apohlman123/capstone-project/pd_patches/CurrentProblemsWithPD.rtf

Pure Data Problems

High Priority:

1. When sampler’s pitch is altered, sample continues to loop instead of playing one time through
2. Attack doesn’t make linear change with sample playback

Other Problems:

Opening sound files with path in Sampler
Adsr envelope array visualization is not accurate
Clicks on filter type change
Reset plays trigger sample over again

Additional creative tasks (not problems)
• Calculating Q value of filter instead of 0 to 1 value
•
