apohlman123/capstone-project/Schematic_Diagrams/H-API_Sequencer.pdf

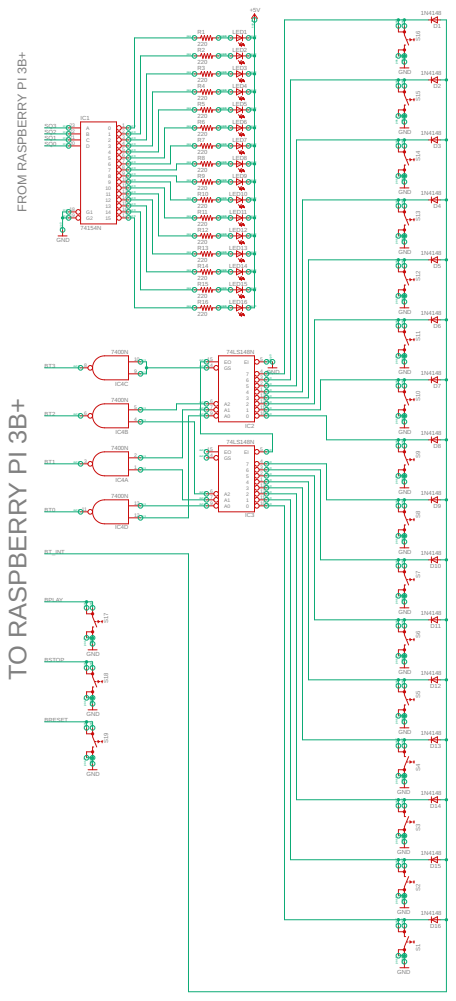
[picture p1: page 1]

FROM RASPBERRY PI 3B+ TO RASPBERRY PI 3B+ +5V GND 220 220 220 220 220 220 220 220 220 220 220 220 220 220 220 220 74154N GND GND GND GND 74LS148N 74LS148N GND 7400N 7400N 7400N 7400N GND GND GND GND GND GND GND GND GND GND GND GND 1N4148 1N4148 1N4148 1N4148 1N4148 1N4148 1N4148 1N4148 1N4148 1N4148 1N4148 1N4148 1N4148 1N4148 1N4148 1N4148 GND GND GND LED1 LED2 LED3 LED4 LED5 LED6 LED7 LED8 LED9 LED10 LED11 LED12 LED13 LED14 LED15 LED16 R1 R2 R3 R4 R5 R6 R7 R8 R9 R10 R11 R12 R13 R14 R15 R16 IC1 0 1 1 2 2 3 3 4 4 5 5 6 6 7 7 8 8 9 9 10 10 11 11 13 12 14 13 15 14 16 15 17 G1 18 G2 19 D 20 C 21 B 22 A 23 S2 S3 S4 S1 S5 S6 S7 S8 S9 S10 S11 S12 S13 S14 S15 S16 IC2 4 1 5 2 6 3 7 4 EI 5 A2 6 A1 7 A0 9 0 10 1 11 2 12 3 13 GS 14 EO 15 IC3 4 1 5 2 6 3 7 4 EI 5 A2 6 A1 7 A0 9 0 10 1 11 2 12 3 13 GS 14 EO 15 IC4A 12 3 IC4B 45 6 IC4C 910 8 IC4D 1213 11 D1 D2 D3 D4 D5 D6 D7 D8 D9 D10 D11 D12 D13 D14 D15 D16 S17 S18 S19 SQ3 SQ2 SQ1 SQ0 BT3 BT2 BT1 BT0 BT_INT BSTOP BPLAY BRESET pas 0 pas 0 pas 0 pas 0 pas 0 pas 0 pas 0 pas 0 pas 0 pas 0 pas 0 pas 0 pas 0 pas 0 pas 0 pas 0 pas 0 pas 0 pas 0 pas 0 pas 0 pas 0 pas 0 pas 0 pas 0 pas 0 pas 0 pas 0 pas 0 pas 0 pas 0 pas 0sup 0 sup 0 pas 1 pas 1 pas 1 pas 1 pas 1 pas 1 pas 1 pas 1 pas 1 pas 1 pas 1 pas 1 pas 1 pas 1 pas 1 pas 1 pas 1 pas 1 pas 1 pas 1 pas 1 pas 1 pas 1 pas 1 pas 1 pas 1 pas 1 pas 1 pas 1 pas 1 pas 1 pas 1 out 0 out 0 out 0 out 0 out 0 out 0 out 0 out 0 out 0 out 0 out 0 out 0 out 0 out 0 out 0 out 0 in 0 in 0 in 0 in 0 in 0 in 0 pas 1 pas 1 pas 2 pas 2 pas 1 pas 1 pas 2 pas 2 pas 1 pas 1 pas 2 pas 2 sup 0 sup 0 pas 1 pas 1 pas 2 pas 2 pas 1 pas 1 pas 2 pas 2 pas 1 pas 1 pas 2 pas 2 pas 1 pas 1 pas 2 pas 2 pas 1 pas 1 pas 2 pas 2 pas 1 pas 1 pas 2 pas 2 pas 1 pas 1 pas 2 pas 2 pas 1 pas 1 pas 2 pas 2 pas 1 pas 1 pas 2 pas 2 pas 1 pas 1 pas 2 pas 2 pas 1 pas 1 pas 2 pas 2 pas 1 pas 1 pas 2 pas 2 pas 1 pas 1 pas 2 pas 2 sup 0 sup 0 in 0 in 0 in 0 in 0 in 0 out 0 out 0 out 0 in 0 in 0 in 0 in 0 out 0 out 0 in 0 in 0 in 0 in 0 in 0 out 0 out 0 out 0 in 0 in 0 in 0 in 0 out 0 out 0 sup 0 in 1 in 1 out 0 in 1 in 1 out 0 in 1 in 1 out 0 in 1 in 1 out 0 sup 0 sup 0 sup 0 sup 0 sup 0 sup 0 sup 0 sup 0 sup 0 sup 0 sup 0 sup 0 pas 1 pas 1 pas 2 pas 2 pas 1 pas 1 pas 2 pas 2 pas 1 pas 1 pas 2 pas 2 sup 0 sup 0 sup 0
