apohlman123/capstone-project/Schematic_Diagrams/H-API_AMP.pdf

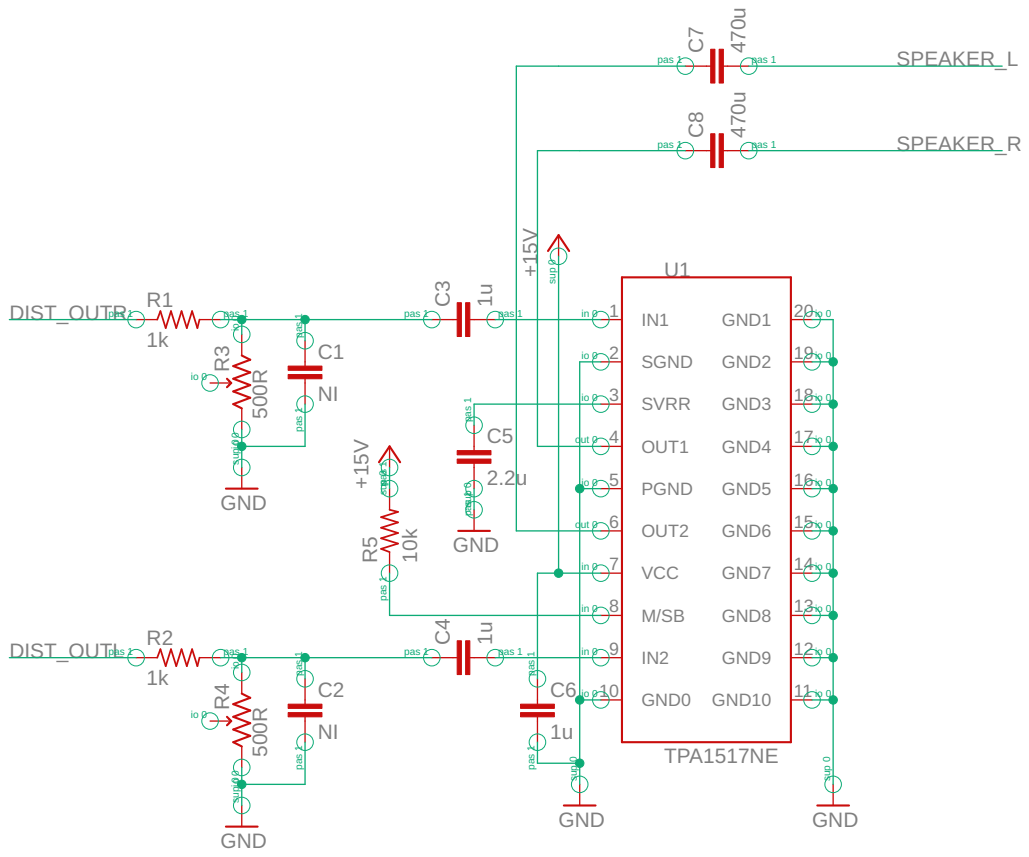
[picture p2: page 1]
