apohlman123/capstone-project/Schematic_Diagrams/H-API_DIST.pdf

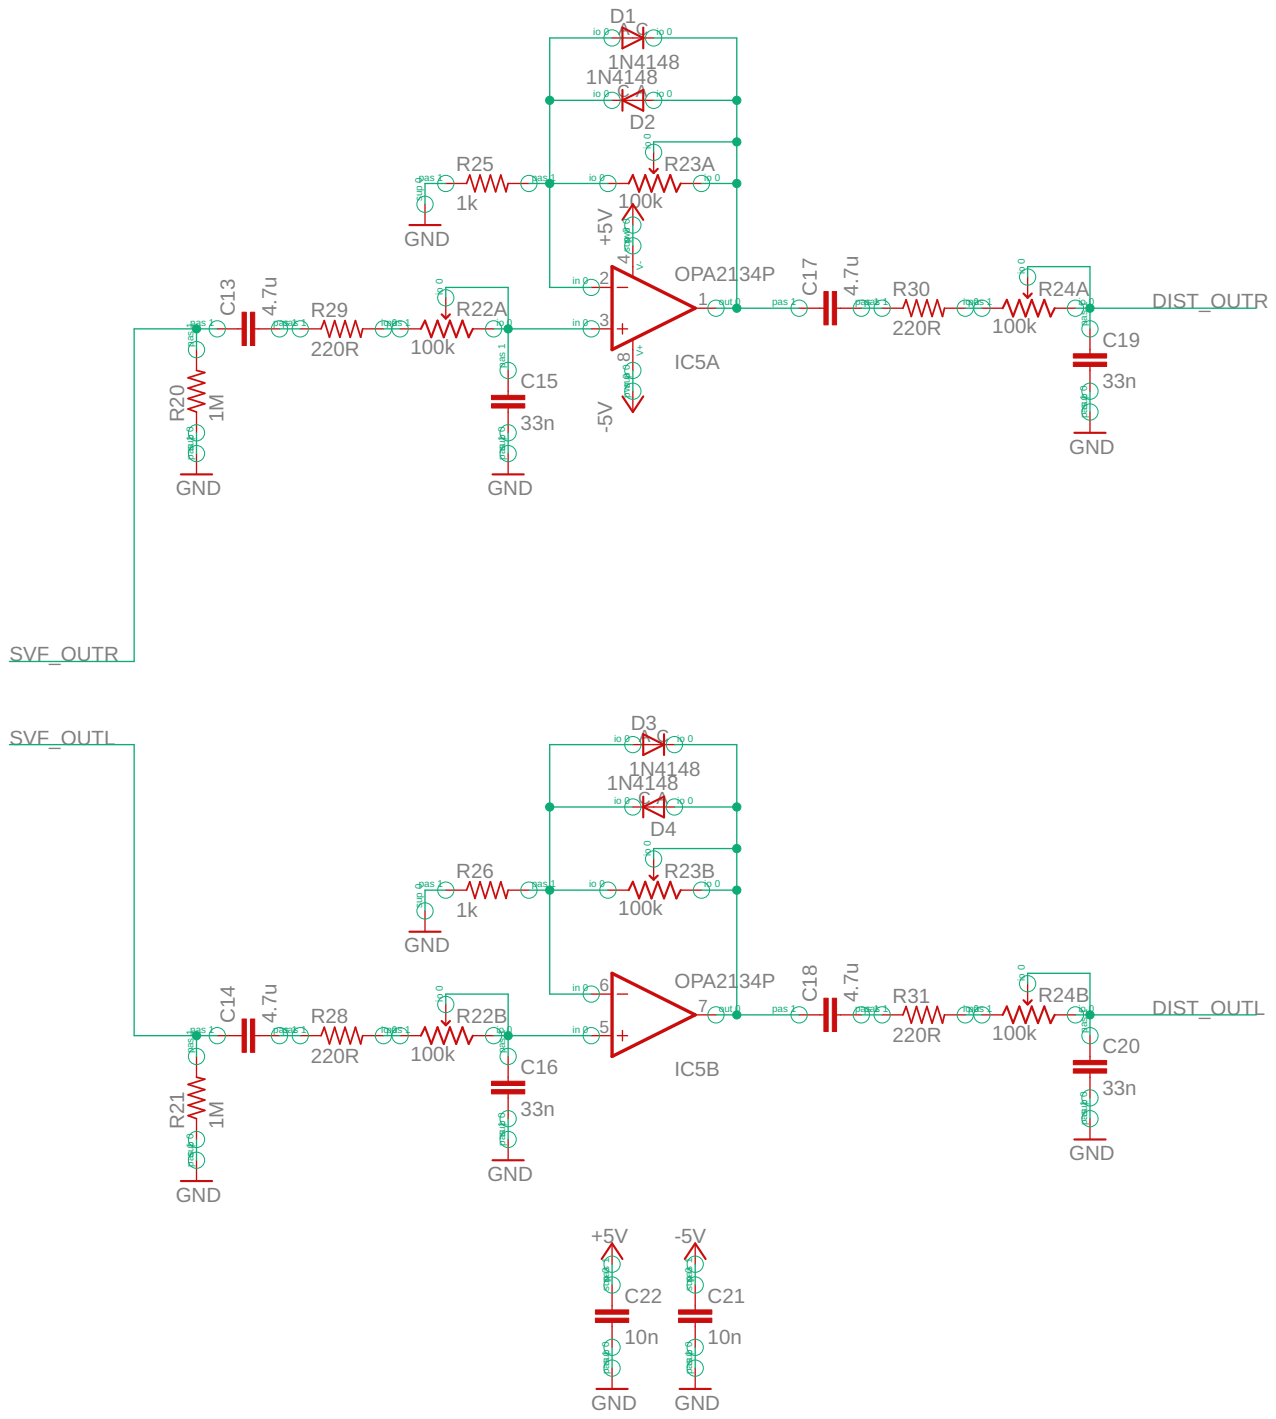
[picture p3: page 1]

pas 1 pas 1 pas 1 pas 1 sup 0 sup 0

pas 1 pas 1
