apohlman123/capstone-project/Schematic_Diagrams/H-API_SVF.pdf

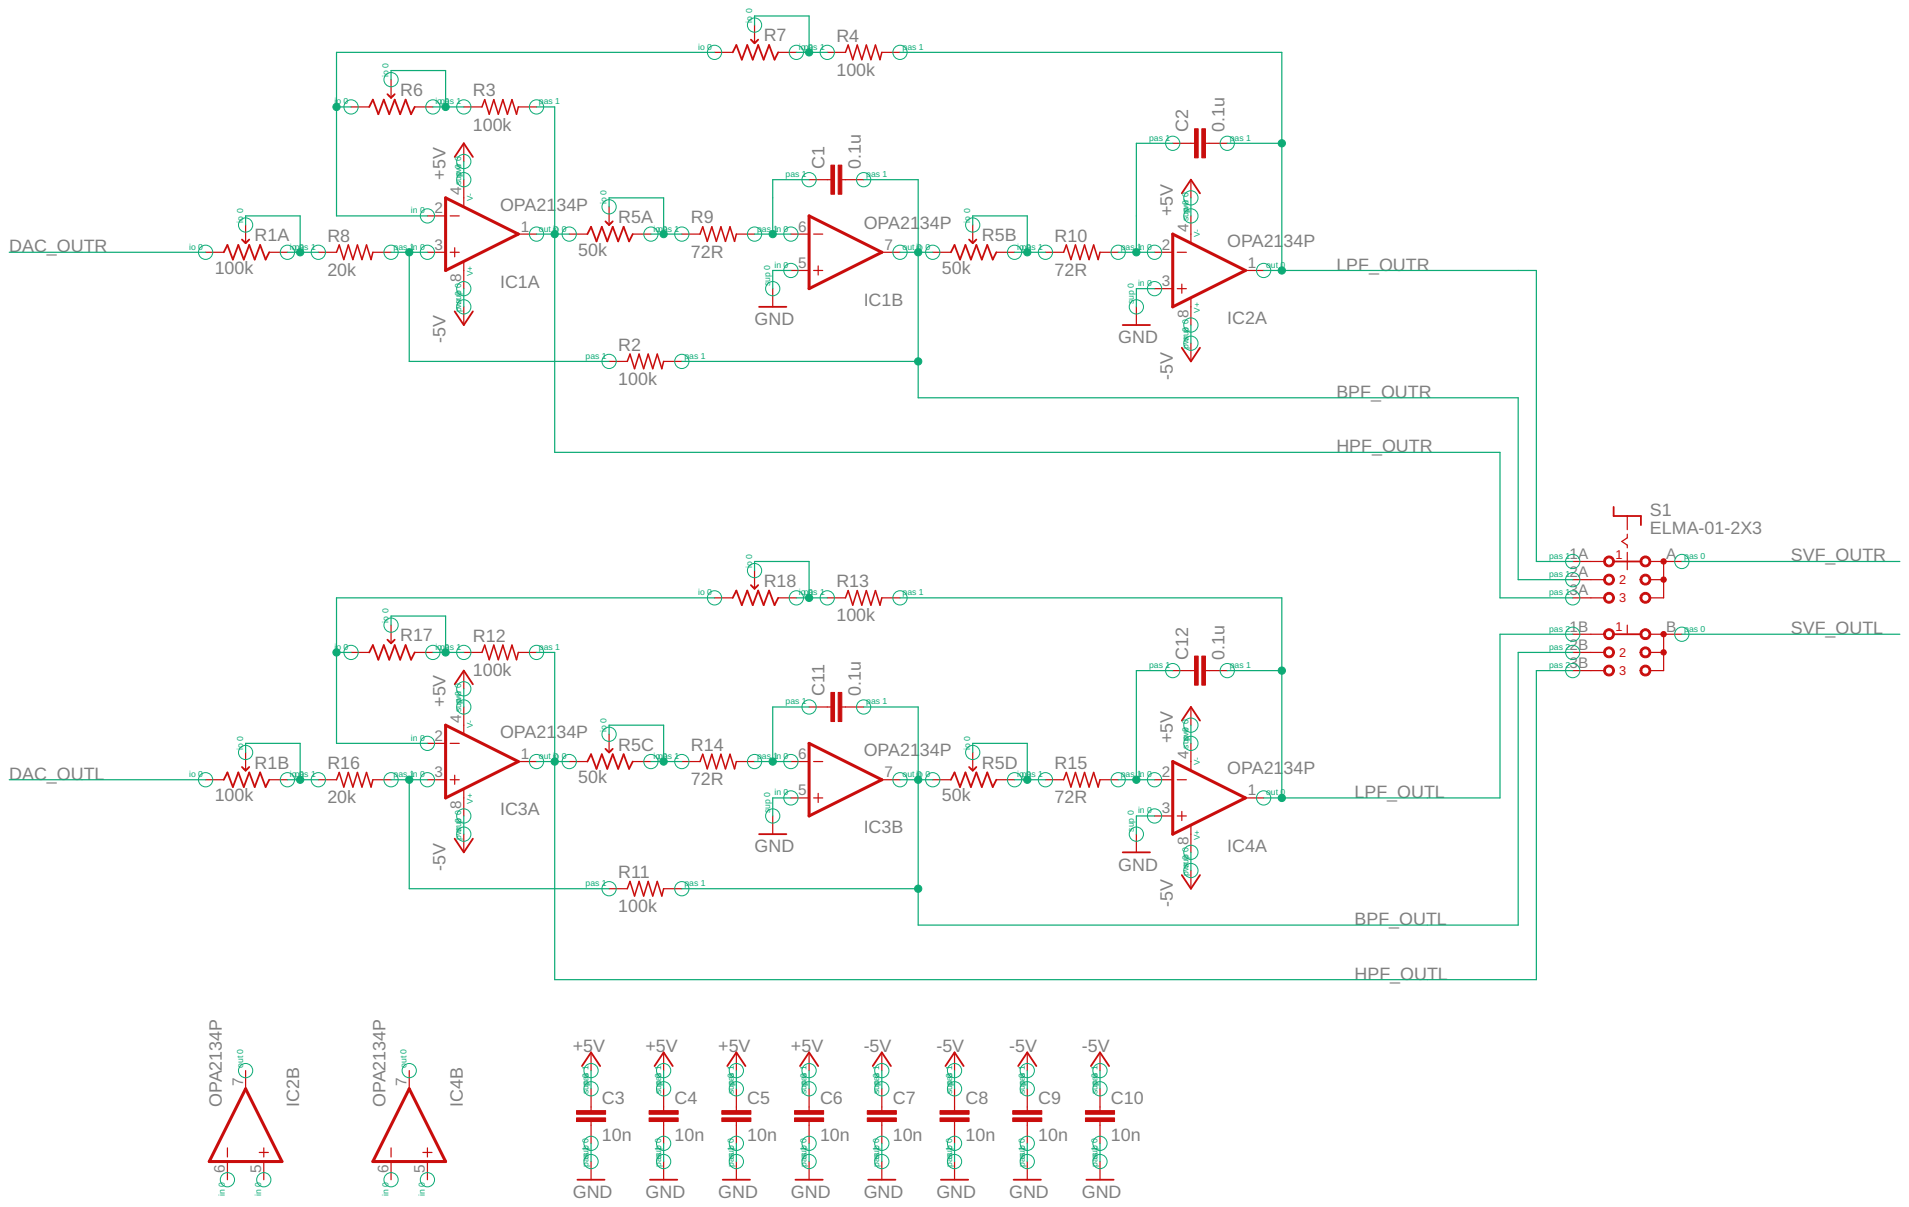
[picture p4: page 1]
