apohlman123/capstone-project/Schematic_Diagrams/H-API_AMP.sch

## EAGLE design Schematic_Diagrams/H-API_AMP.sch (2019-05-10)

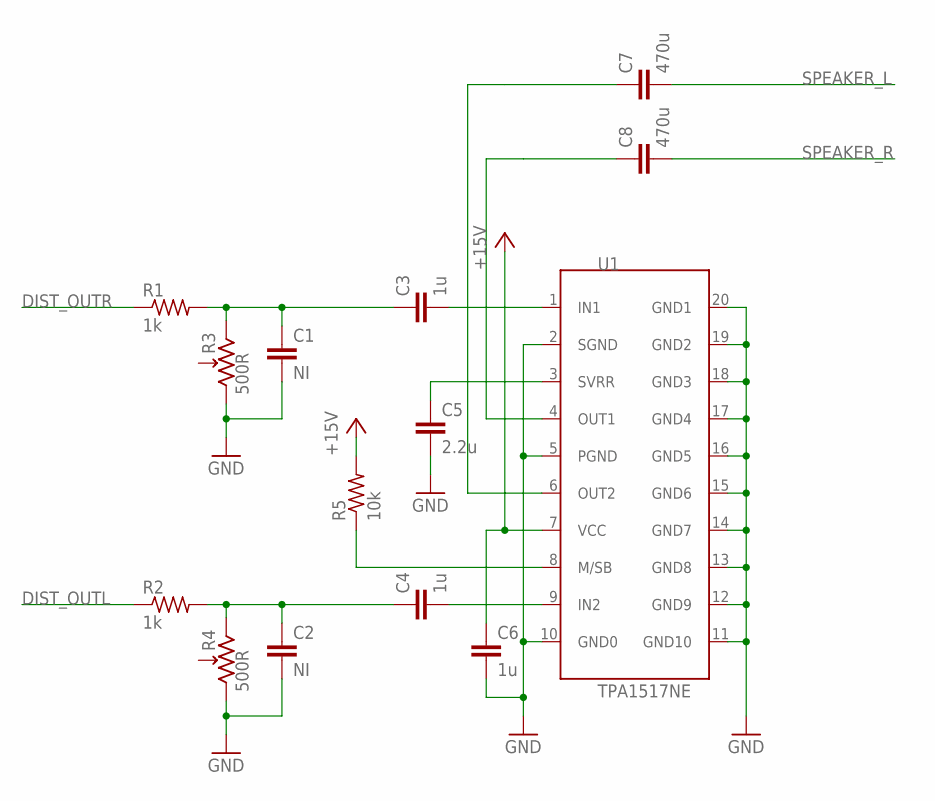
[picture p5: schematic H-API_AMP.sch]

Parts:
C1, C2: NI; C0805
C3, C4, C6: 1u; C0805
C5: 2.2u; C0805
C7, C8: 470u; C0805
R1, R2: 1k; VMTA55
R3, R4: 500R; CT6
R5: 10k; VTA55
U1: TPA1517NE; DIP20

Connections:
+5V: C6.1, R5.2, U1.7 (VCC)
DIST_OUTL: R2.1
DIST_OUTR: R1.1
GND: C1.2, C2.2, C5.2, C6.2, R3.A (1), R4.A (1), U1.2 (SGND), U1.5 (PGND), U1.10 (GND0), U1.11 (GND10), U1.12 (GND9), U1.13 (GND8), U1.14 (GND7), U1.15 (GND6), U1.16 (GND5), U1.17 (GND4), U1.18 (GND3), U1.19 (GND2), U1.20 (GND1)
unnamed: C1.1, C3.1, R1.2, R3.E (3)
unnamed: C2.1, C4.1, R2.2, R4.E (3)
unnamed: C3.2, U1.1 (IN1)
unnamed: C4.2, U1.9 (IN2)
unnamed: C5.1, U1.3 (SVRR)
unnamed: C8.1, U1.4 (OUT1)
unnamed: R5.1, U1.8 (M/SB)
unnamed: C7.1, U1.6 (OUT2)
SPEAKER_L: C7.2
SPEAKER_R: C8.2
