apohlman123/capstone-project/Schematic_Diagrams/H-API_DIST.sch

## EAGLE design Schematic_Diagrams/H-API_DIST.sch (2019-05-10)

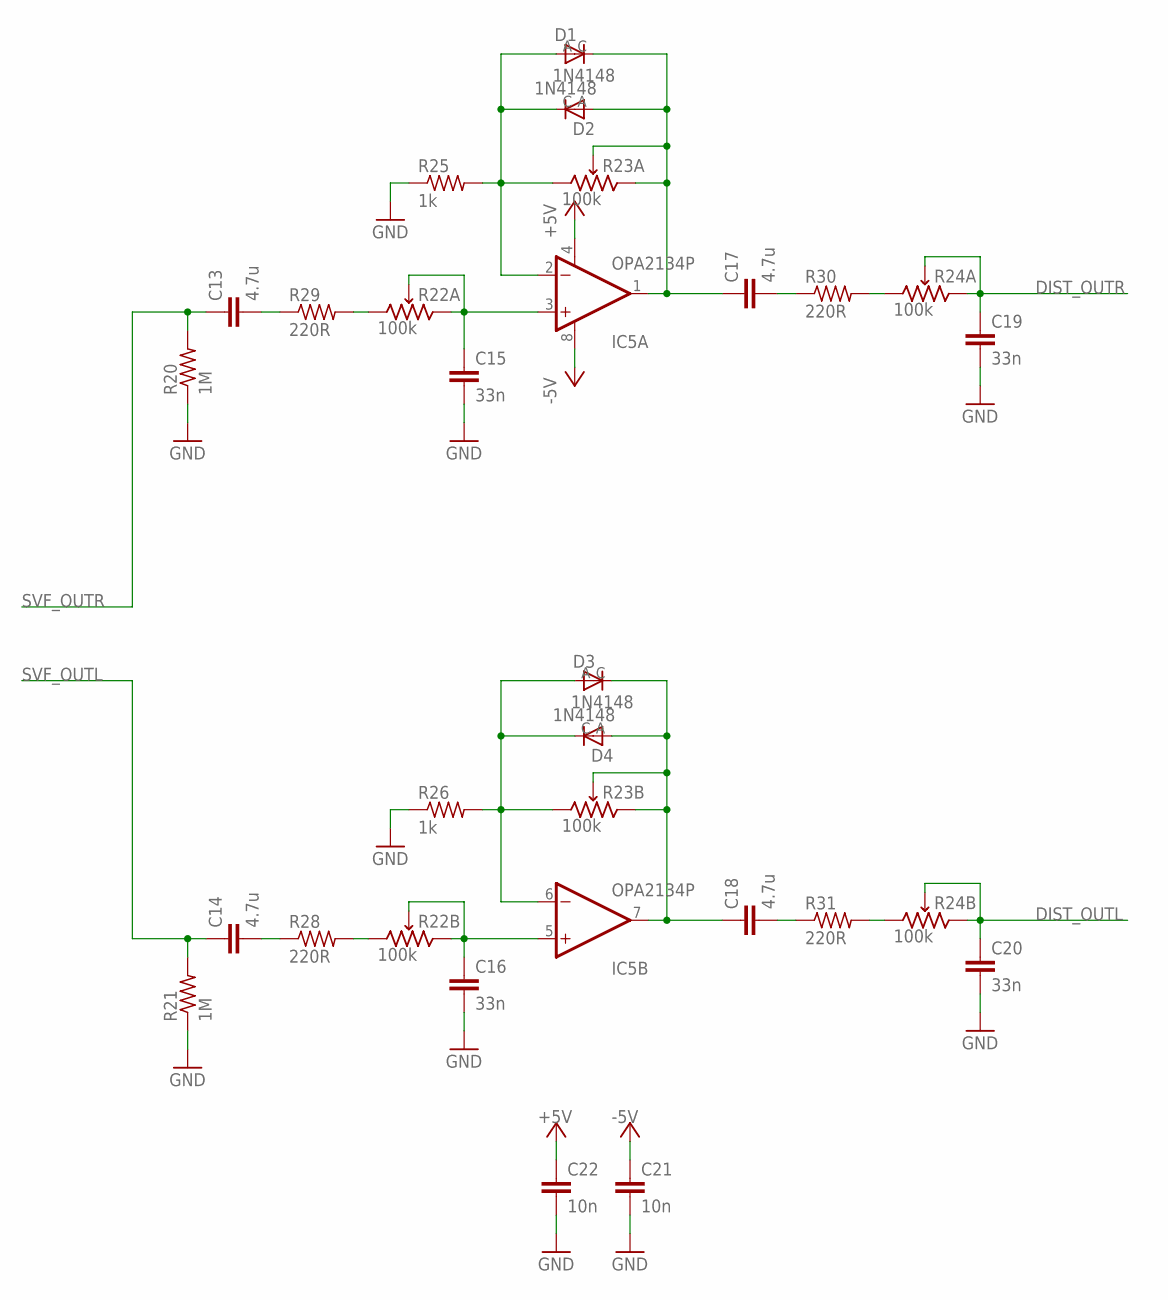
[picture p6: schematic H-API_DIST.sch]

Parts:
C13, C14, C17, C18: 4.7u; C0805
C15, C16, C19, C20: 33n; C0805
C21, C22: 10n; C0805
D1, D2, D3, D4: 1N4148; DO41-7
IC5: OPA2134P; DIL08
R20, R21: 1M; VMTA55
R22, R23, R24: 100k; POT2-SW
R25, R26: 1k; VMTA55
R28, R29, R30, R31: 220R; VMTA55

Connections:
+5V: C22.1, IC5.4 (V-)
-5V: C21.1, IC5.8 (V+)
DIST_OUTL: C20.1, R24.2E (3), R24.2S (2)
DIST_OUTR: C19.1, R24.1E (3), R24.1S (2)
GND: C15.2, C16.2, C19.2, C20.2, C21.2, C22.2, R20.1, R21.1, R25.1, R26.1
unnamed: C14.2, R28.1
unnamed: C13.2, R29.1
unnamed: R22.1A (1), R29.2
unnamed: R22.2A (1), R28.2
unnamed: D1.A, D2.C, IC5.2 (-IN), R23.1A (1), R25.2
unnamed: D3.A, D4.C, IC5.6 (-IN), R23.2A (1), R26.2
unnamed: C18.1, D3.C, D4.A, IC5.7 (OUT), R23.2E (3), R23.2S (2)
unnamed: C17.1, D1.C, D2.A, IC5.1 (OUT), R23.1E (3), R23.1S (2)
unnamed: C18.2, R31.1
unnamed: C16.1, IC5.5 (+IN), R22.2E (3), R22.2S (2)
unnamed: C17.2, R30.1
unnamed: C15.1, IC5.3 (+IN), R22.1E (3), R22.1S (2)
unnamed: R24.1A (1), R30.2
unnamed: R24.2A (1), R31.2
SVF_OUTL: C14.1, R21.2
SVF_OUTR: C13.1, R20.2
