apohlman123/capstone-project/Schematic_Diagrams/H-API_SVF.sch

## EAGLE design Schematic_Diagrams/H-API_SVF.sch (2019-05-10)

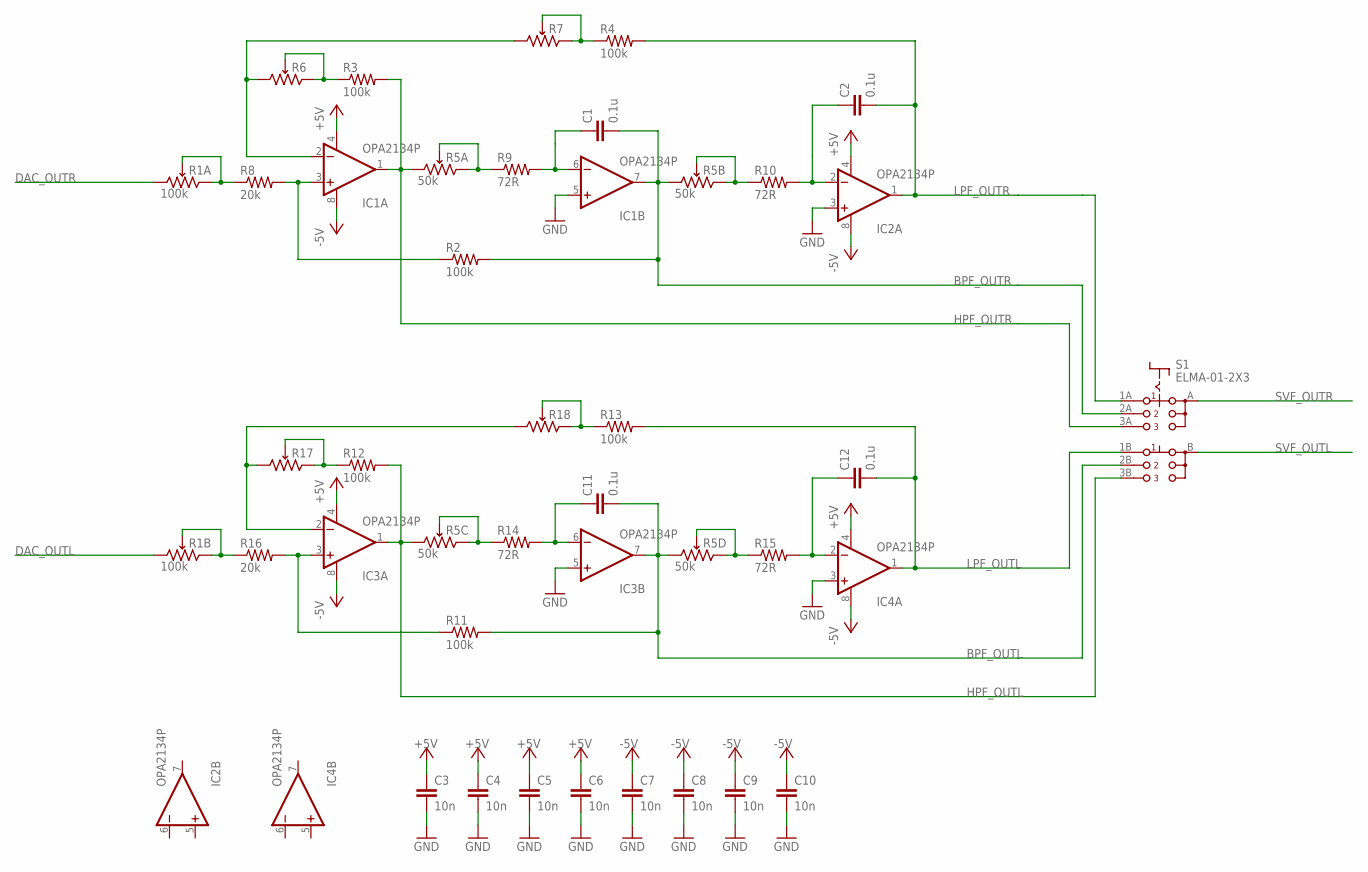
[picture p7: schematic H-API_SVF.sch]

Parts:
C1, C2, C11, C12: 0.1u; C0805
C3, C4, C5, C6, C7, C8, C9, C10: 10n; C0805
IC1, IC2, IC3, IC4: OPA2134P; DIL08
R1: 100k; POT2-SW
R2, R3, R4, R11, R12, R13: 100k; VMTA55
R5: 50k; POT4
R6, R7, R17, R18: TRIM-POT; CT6
R8, R16: 20k; VMTA55
R9, R10, R14, R15: 72R; VMTA55
S1: ELMA-01-2X3

Connections:
+5V: C3.1, C4.1, C5.1, C6.1, IC1.4 (V-), IC2.4 (V-), IC3.4 (V-), IC4.4 (V-)
-5V: C7.1, C8.1, C9.1, C10.1, IC1.8 (V+), IC2.8 (V+), IC3.8 (V+), IC4.8 (V+)
BPF_OUTL: C11.2, IC3.7 (OUT), R5.4A (1), R11.2, S1.2B (B2)
BPF_OUTR: C1.2, IC1.7 (OUT), R2.2, R5.2A (1), S1.2A (A2)
DAC_OUTL: R1.2A (1)
DAC_OUTR: R1.1A (1)
GND: C3.2, C4.2, C5.2, C6.2, C7.2, C8.2, C9.2, C10.2, IC1.5 (+IN), IC2.3 (+IN), IC3.5 (+IN), IC4.3 (+IN)
HPF_OUTL: IC3.1 (OUT), R5.3A (1), R12.2, S1.3B (B3)
HPF_OUTR: IC1.1 (OUT), R3.2, R5.1A (1), S1.3A (A3)
LPF_OUTL: C12.2, IC4.1 (OUT), R13.2, S1.1B (B1)
LPF_OUTR: C2.2, IC2.1 (OUT), R4.2, S1.1A (A1)
unnamed: IC1.3 (+IN), R2.1, R8.2
unnamed: R1.2E (3), R1.2S (2), R16.1
unnamed: R1.1E (3), R1.1S (2), R8.1
unnamed: C2.1, IC2.2 (-IN), R10.2
unnamed: C1.1, IC1.6 (-IN), R9.2
unnamed: IC3.3 (+IN), R11.1, R16.2
unnamed: IC3.2 (-IN), R17.A (1), R18.A (1)
unnamed: R5.1E (3), R5.1S (2), R9.1
unnamed: IC1.2 (-IN), R6.A (1), R7.A (1)
unnamed: R3.1, R6.E (3), R6.S (2)
unnamed: R5.3E (3), R5.3S (2), R14.1
unnamed: R4.1, R7.E (3), R7.S (2)
unnamed: R5.2E (3), R5.2S (2), R10.1
unnamed: C11.1, IC3.6 (-IN), R14.2
unnamed: R5.4E (3), R5.4S (2), R15.1
unnamed: C12.1, IC4.2 (-IN), R15.2
unnamed: R12.1, R17.E (3), R17.S (2)
unnamed: R13.1, R18.E (3), R18.S (2)
SVF_OUTL: S1.B
SVF_OUTR: S1.A
