apohlman123/capstone-project/Schematic_Diagrams/H-API_Sequencer.sch

## EAGLE design Schematic_Diagrams/H-API_Sequencer.sch (2019-05-10)

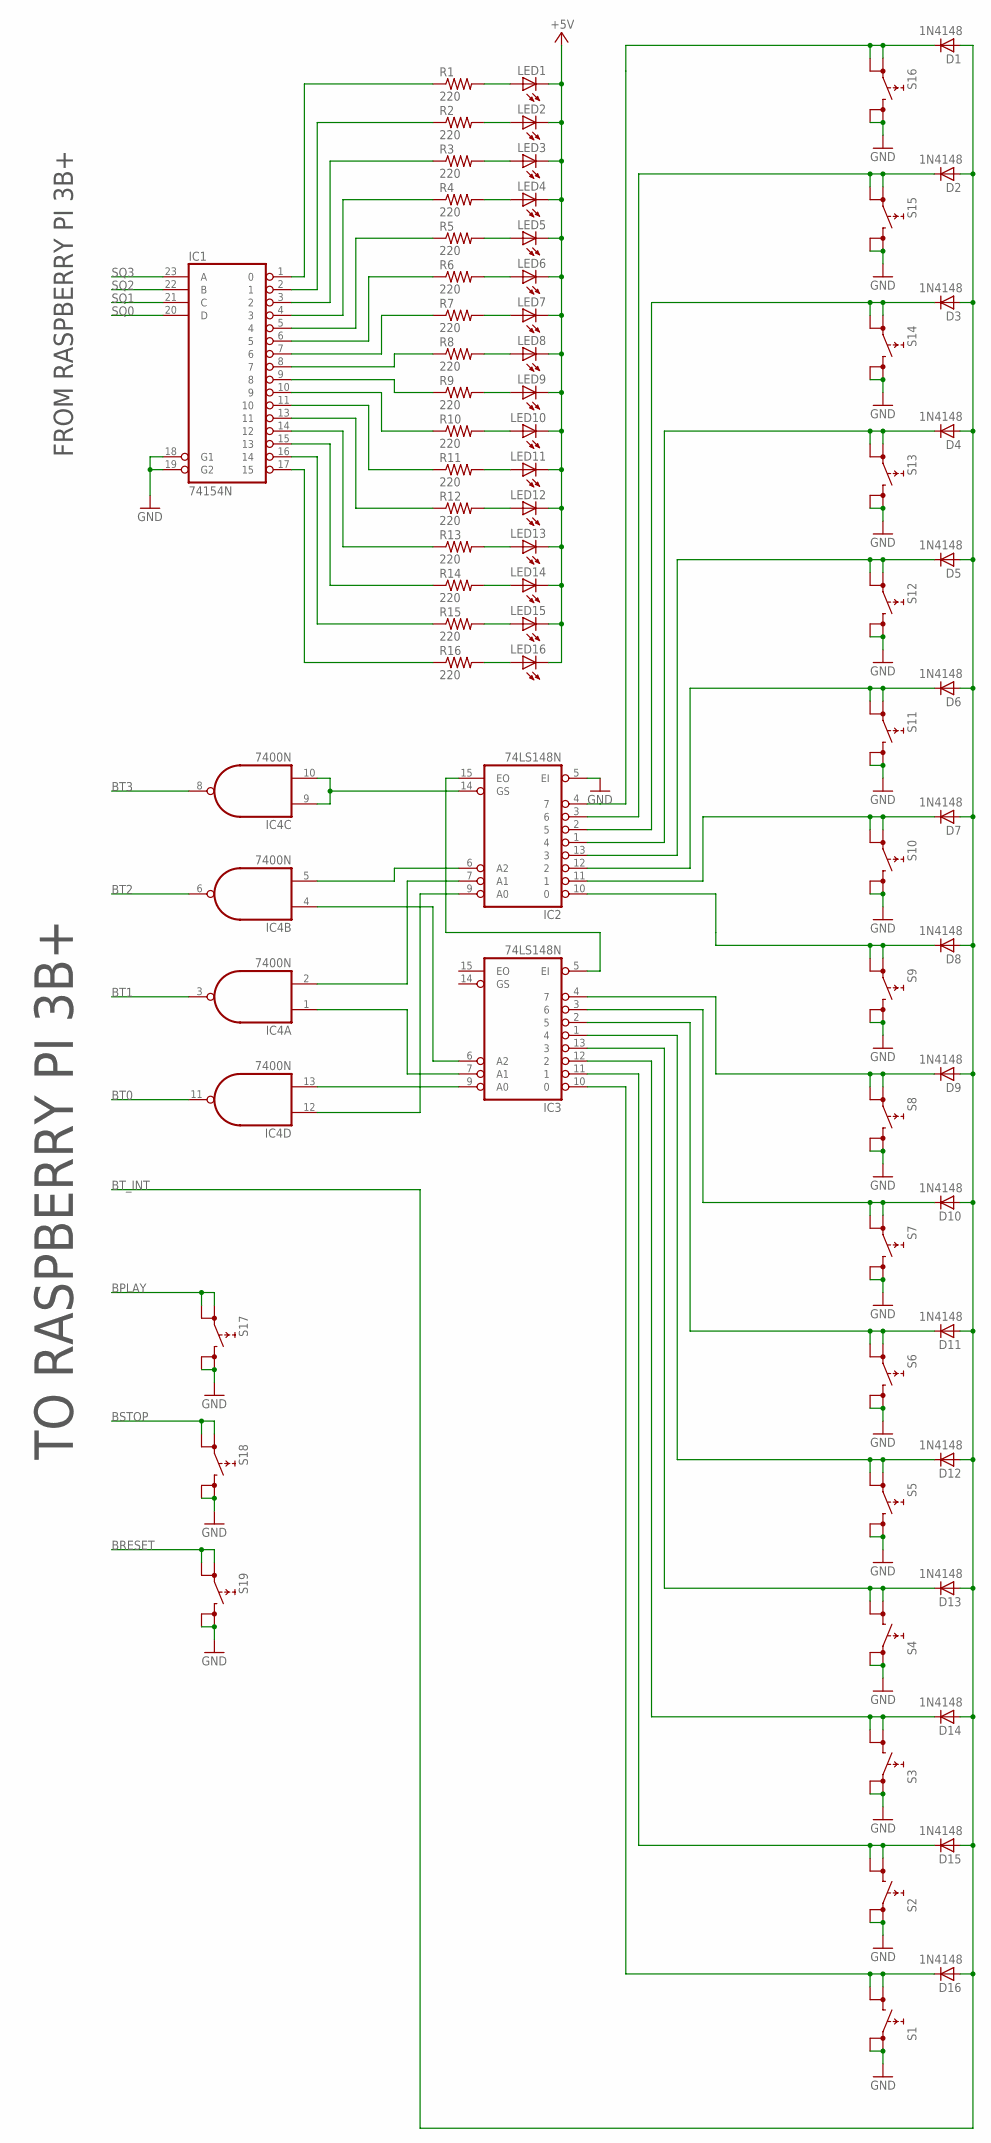
[picture p8: schematic H-API_Sequencer.sch]

Parts:
IC1: 74154N; DIL24-6
IC2, IC3: 74LS148N; DIL16
IC4: 7400N; DIL14
LED1, LED2, LED3, LED4, LED5, LED6, LED7, LED8, LED9, LED10, LED11, LED12, LED13, LED14, LED15, LED16: LED5MM
R1, R2, R3, R4, R5, R6, R7, R8, R9, R10, R11, R12, R13, R14, R15, R16: 220; VMTA55
S1, S2, S3, S4, S5, S6, S7, S8, S9, S10, S11, S12, S13, S14, S15, S16, S17, S18, S19: REKN

Connections:
+5V: LED1.K (C), LED2.K (C), LED3.K (C), LED4.K (C), LED5.K (C), LED6.K (C), LED7.K (C), LED8.K (C), LED9.K (C), LED10.K (C), LED11.K (C), LED12.K (C), LED13.K (C), LED14.K (C), LED15.K (C), LED16.K (C)
BPLAY: S17.0A (0), S17.0B (0)
BRESET: S19.0A (0), S19.0B (0)
BSTOP: S18.0A (0), S18.0B (0)
BT0: IC4.11 (O)
BT1: IC4.3 (O)
BT2: IC4.6 (O)
BT3: IC4.8 (O)
GND: IC1.18 (G1), IC1.19 (G2), IC2.5 (EI), S1.0A (0), S1.0B (0), S2.0A (0), S2.0B (0), S3.0A (0), S3.0B (0), S4.0A (0), S4.0B (0), S5.1A (1), S5.1B (1), S6.1A (1), S6.1B (1), S7.1A (1), S7.1B (1), S8.1A (1), S8.1B (1), S9.1A (1), S9.1B (1), S10.1A (1), S10.1B (1), S11.1A (1), S11.1B (1), S12.1A (1), S12.1B (1), S13.1A (1), S13.1B (1), S14.1A (1), S14.1B (1), S15.1A (1), S15.1B (1), S16.1A (1), S16.1B (1), S17.1A (1), S17.1B (1), S18.1A (1), S18.1B (1), S19.1A (1), S19.1B (1)
unnamed: LED1.A, R1.2
unnamed: LED2.A, R2.2
unnamed: LED3.A, R3.2
unnamed: IC1.4 (3), R4.1
unnamed: LED5.A, R5.2
unnamed: LED6.A, R6.2
unnamed: LED7.A, R7.2
unnamed: LED8.A, R8.2
unnamed: LED9.A, R9.2
unnamed: LED10.A, R10.2
unnamed: LED11.A, R11.2
unnamed: LED12.A, R12.2
unnamed: LED13.A, R13.2
unnamed: LED14.A, R14.2
unnamed: LED15.A, R15.2
unnamed: LED16.A, R16.2
unnamed: IC1.1 (0), R1.1
unnamed: IC1.2 (1), R2.1
unnamed: IC1.3 (2), R3.1
unnamed: LED4.A, R4.2
unnamed: IC1.5 (4), R5.1
unnamed: IC1.6 (5), R6.1
unnamed: IC1.7 (6), R7.1
unnamed: IC1.8 (7), R8.1
unnamed: IC1.9 (8), R9.1
unnamed: IC1.10 (9), R10.1
unnamed: IC1.11 (10), R11.1
unnamed: IC1.13 (11), R12.1
unnamed: IC1.14 (12), R13.1
unnamed: IC1.15 (13), R14.1
unnamed: IC1.16 (14), R15.1
unnamed: IC1.17 (15), R16.1
unnamed: IC2.15 (EO), IC3.5 (EI)
unnamed: IC2.4 (7), S16.0A (0), S16.0B (0)
unnamed: IC2.3 (6), S15.0A (0), S15.0B (0)
unnamed: IC2.2 (5), S14.0A (0), S14.0B (0)
unnamed: IC2.13 (3), S12.0A (0), S12.0B (0)
unnamed: IC2.1 (4), S13.0A (0), S13.0B (0)
unnamed: IC2.12 (2), S11.0A (0), S11.0B (0)
unnamed: IC2.11 (1), S10.0A (0), S10.0B (0)
unnamed: IC2.10 (0), S9.0A (0), S9.0B (0)
unnamed: IC3.4 (7), S8.0A (0), S8.0B (0)
unnamed: IC3.3 (6), S7.0A (0), S7.0B (0)
unnamed: IC3.2 (5), S6.0A (0), S6.0B (0)
unnamed: IC3.1 (4), S5.0A (0), S5.0B (0)
unnamed: IC3.13 (3), S4.1A (1), S4.1B (1)
unnamed: IC3.12 (2), S3.1A (1), S3.1B (1)
unnamed: IC3.11 (1), S2.1A (1), S2.1B (1)
unnamed: IC3.10 (0), S1.1A (1), S1.1B (1)
unnamed: IC2.14 (GS), IC4.9 (I0), IC4.10 (I1)
unnamed: IC2.7 (A1), IC4.2 (I1)
unnamed: IC3.7 (A1), IC4.1 (I0)
unnamed: IC3.6 (A2), IC4.4 (I0)
unnamed: IC2.6 (A2), IC4.5 (I1)
unnamed: IC3.9 (A0), IC4.13 (I1)
unnamed: IC2.9 (A0), IC4.12 (I0)
SQ0: IC1.20 (D)
SQ1: IC1.21 (C)
SQ2: IC1.22 (B)
SQ3: IC1.23 (A)

Notes on the sheet:
FROM RASPBERRY PI 3B+
TO RASPBERRY PI 3B+
