apohlman123/capstone-project/(commit log)

2018-11-26 Added button-interrupt to sequencer
2018-11-26 Start button integrated
2019-04-08 Upload for current pd patches with RPi externals
2019-04-15 Syntax error line 141
    [Python2PD_RPi.py]
2019-04-16 Removed interrupt-driven touchpad functionality
2019-04-24 Added shift button for sequencer
2019-04-29 Removed print statements for final
2019-05-10 Added Eagle diagrams
    [H-API_AMP.sch, H-API_DIST.sch, H-API_SVF.sch, H-API_Sequencer.sch]
2019-05-10 Added bass samples
2019-05-10 More samples added
2019-05-10 Renamed schematic folder
    [H-API_AMP.sch, H-API_DIST.sch, H-API_SVF.sch, H-API_Sequencer.sch]
